ggrummer/PowerTimer/PowerTimerBOM_RevC.xlsx

Power Timer Assembly Parts Lists
Top Level Parts List
Description |  | Qty | Manufacturer | Part Number | Distributer
Power Block, 4 Outlet |  | 1 | Commercial Electric | 1007 546 208 | Home Depot
Screw, 4-40, 5/8" Long |  | 2 |  | 91772A112 | McMaster-Carr
Heat-Set Inserts for Plastic, Stainless Steel, 4-40 |  | 2 |  | 94459A426 | McMaster-Carr
Spacer Top |  | 1 | 3D Printed | Spacer Top2.stl
Spacer Bottom |  | 1 | 3D Printed | Spacer Bot.stl
Push Button Holder |  | 2 | 3D Printed | PushButHold.stl
Power Timer PCB Rev C |  | 1 | OSH Park or your choice | PowerTimerDesign.kicad_pcb
PCB Parts List |  |  |  |  | Rev C
Description | Reference | Qty | Manufacturer | Part Number | Distributer
Cap 270uF, 25V, Alum, Radial | C1,C6,C9,C12 | 4 | PANASONIC ELECTRONIC | EEU-FK1E271 | Digi-Key
Cap 0.1uF, 50V X7R, Radial | C2,C4,C7,C10,C13,C14,C15,C16 | 8 | Kemet | C326C104K5R5TA7301 | Digi-Key
Cap 0.01uF, 50V X7R, Radial | C3,C5,C8,C11 | 4 | Kemet | C316C103K5R5TA7301 | Digi-Key
Diode, Schottky, Axial, 1A, 20V | D1,D2,D3,D4 | 4 | MCC | 1N5817-TP | Digi-Key
Diode, Axial, 2A, 400V | D5 | 1 | Vishay Semiconductor | 1N5060TR | Digi-Key
AC/DC Converter 12V 3W | PS1 | 1 | RECOM POWER | RAC03-12SK | Digi-Key
Res, 1M, 1%, 1/4W | R1 | 1 | YAGEO | MFR-25FBF52-1M | Digi-Key
Res, 4.7K, 5%, 1/4W | R2,R5,R8,R11 | 4 | Stackpole | CF14JT4K70 | Digi-Key
Res, 680, 5%, 1/4W | R3,R4,R7,R10 | 4 | Stackpole | CF14JT680R | Digi-Key
Res, 2M, 1%, 1/4W | R6 | 1 | YAGEO | MFR-25FBF52-2M | Digi-Key
Res, 12.1M, 1%, 1/4W | R9 | 1 | KOA SPEER ELECTRONICS | RK1/4DCT52R1215F | Digi-Key
Relay, SPST 20A 12V | RL1 | 1 | AMERICAN ZETTLER | AZ762FV-1AE-12DF | Digi-Key
Switch, Push Button, Illumined | SW1,SW2,SW3,SW4 | 4 | SCHURTER | 0041.9146.3317 | Digi-Key
Timer, Dual, DIP14 | U1,U2 | 2 | TEXAS INSTRUMENTS | NE556N | Digi-Key
NAND Gate, 4-Input, Dual, DIP14 | U3,U4 | 2 | TEXAS INSTRUMENTS | CD4082BE | Digi-Key
