ggrummer/PowerTimer/PushButHold.stl

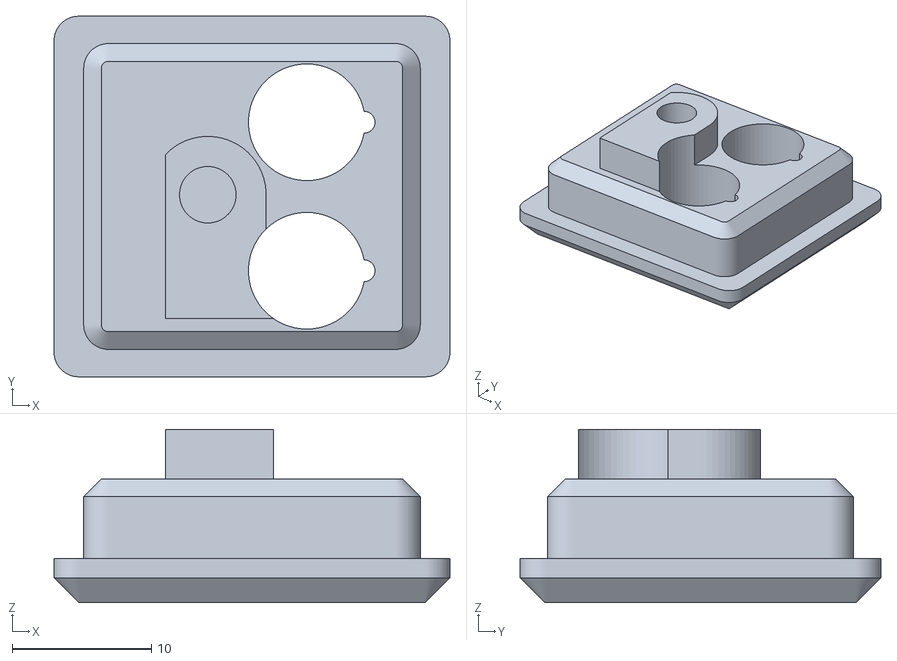
[picture p9: CAD file, 2026-03-17]
PushButHold.stl
28.4 x 25.9 x 12.4
