ggrummer/PowerTimer/Spacer Top2.stl

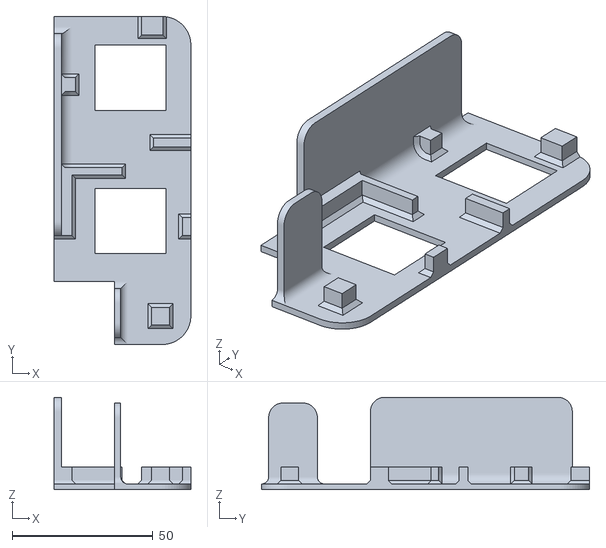
[picture p10: CAD file, 2026-03-17]
Spacer Top2.stl
48.5 x 116.3 x 32.8
