ggrummer/PowerTimer/Spacer Bot.stl

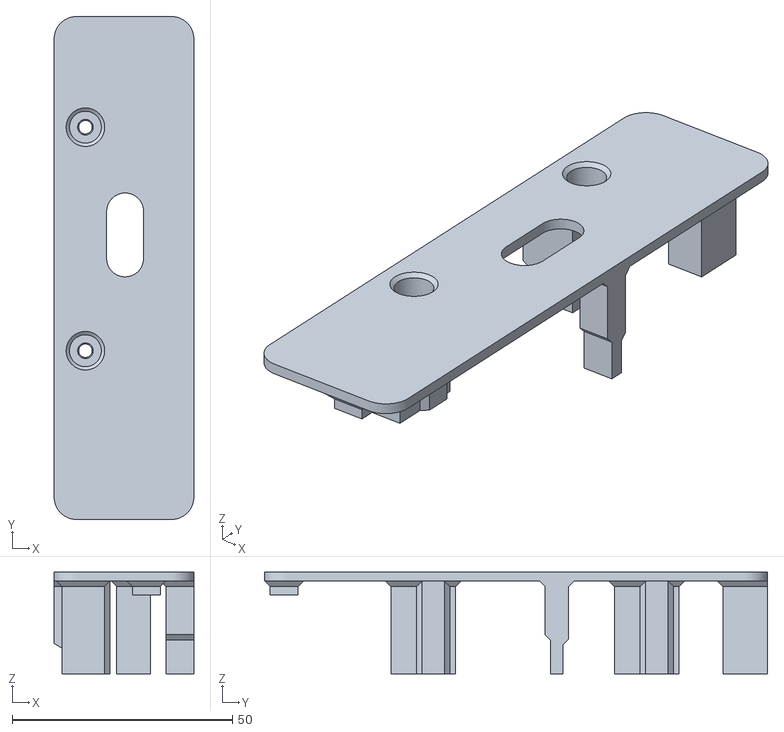
[picture p11: CAD file, 2026-03-17]
Spacer Bot.stl
31.8 x 114.3 x 23.2
