ggrummer/PowerTimer/PushButHold Drawing.pdf

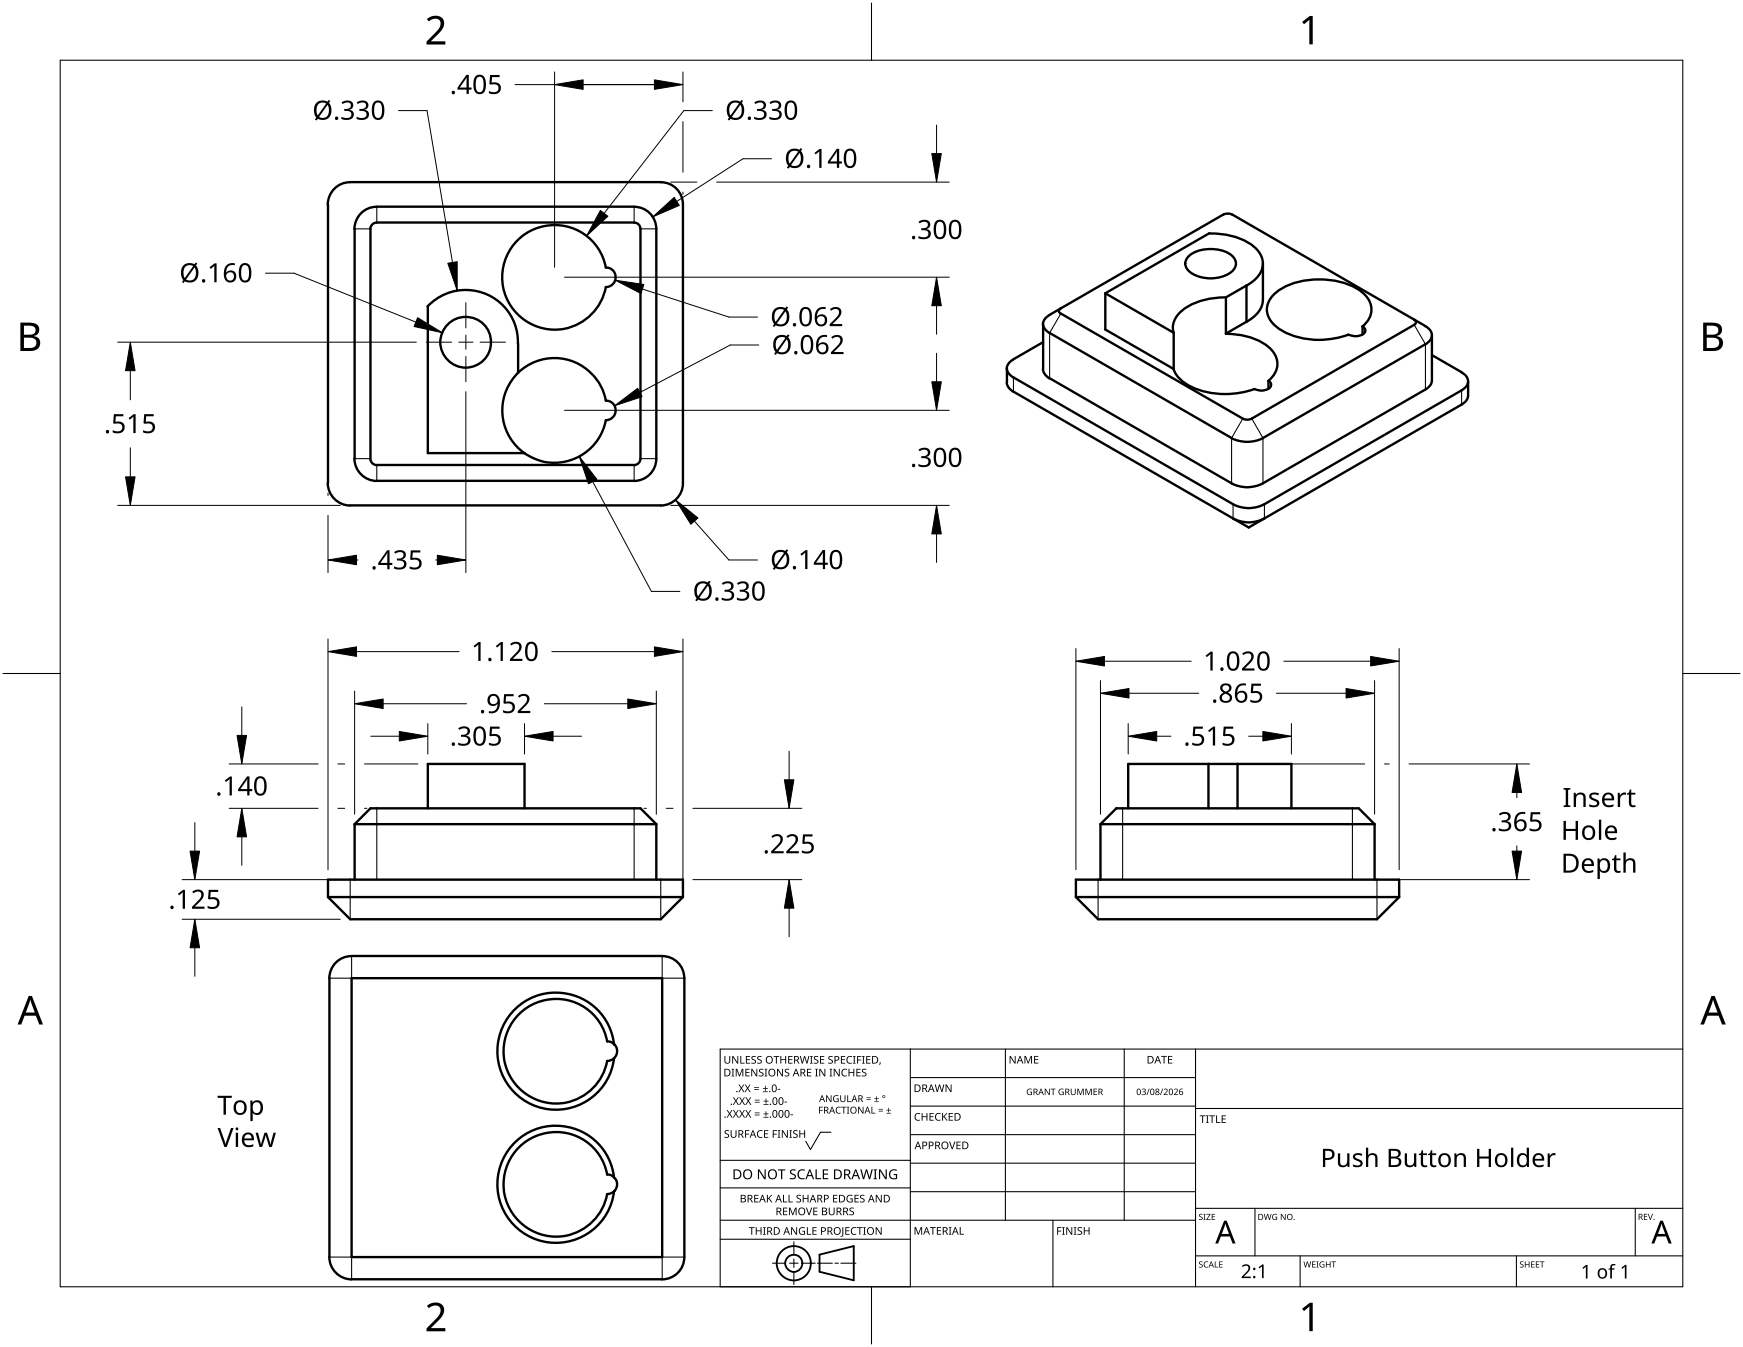
[picture p15: page 1]
