ggrummer/PowerTimer/Spacer Bot Drawing.pdf

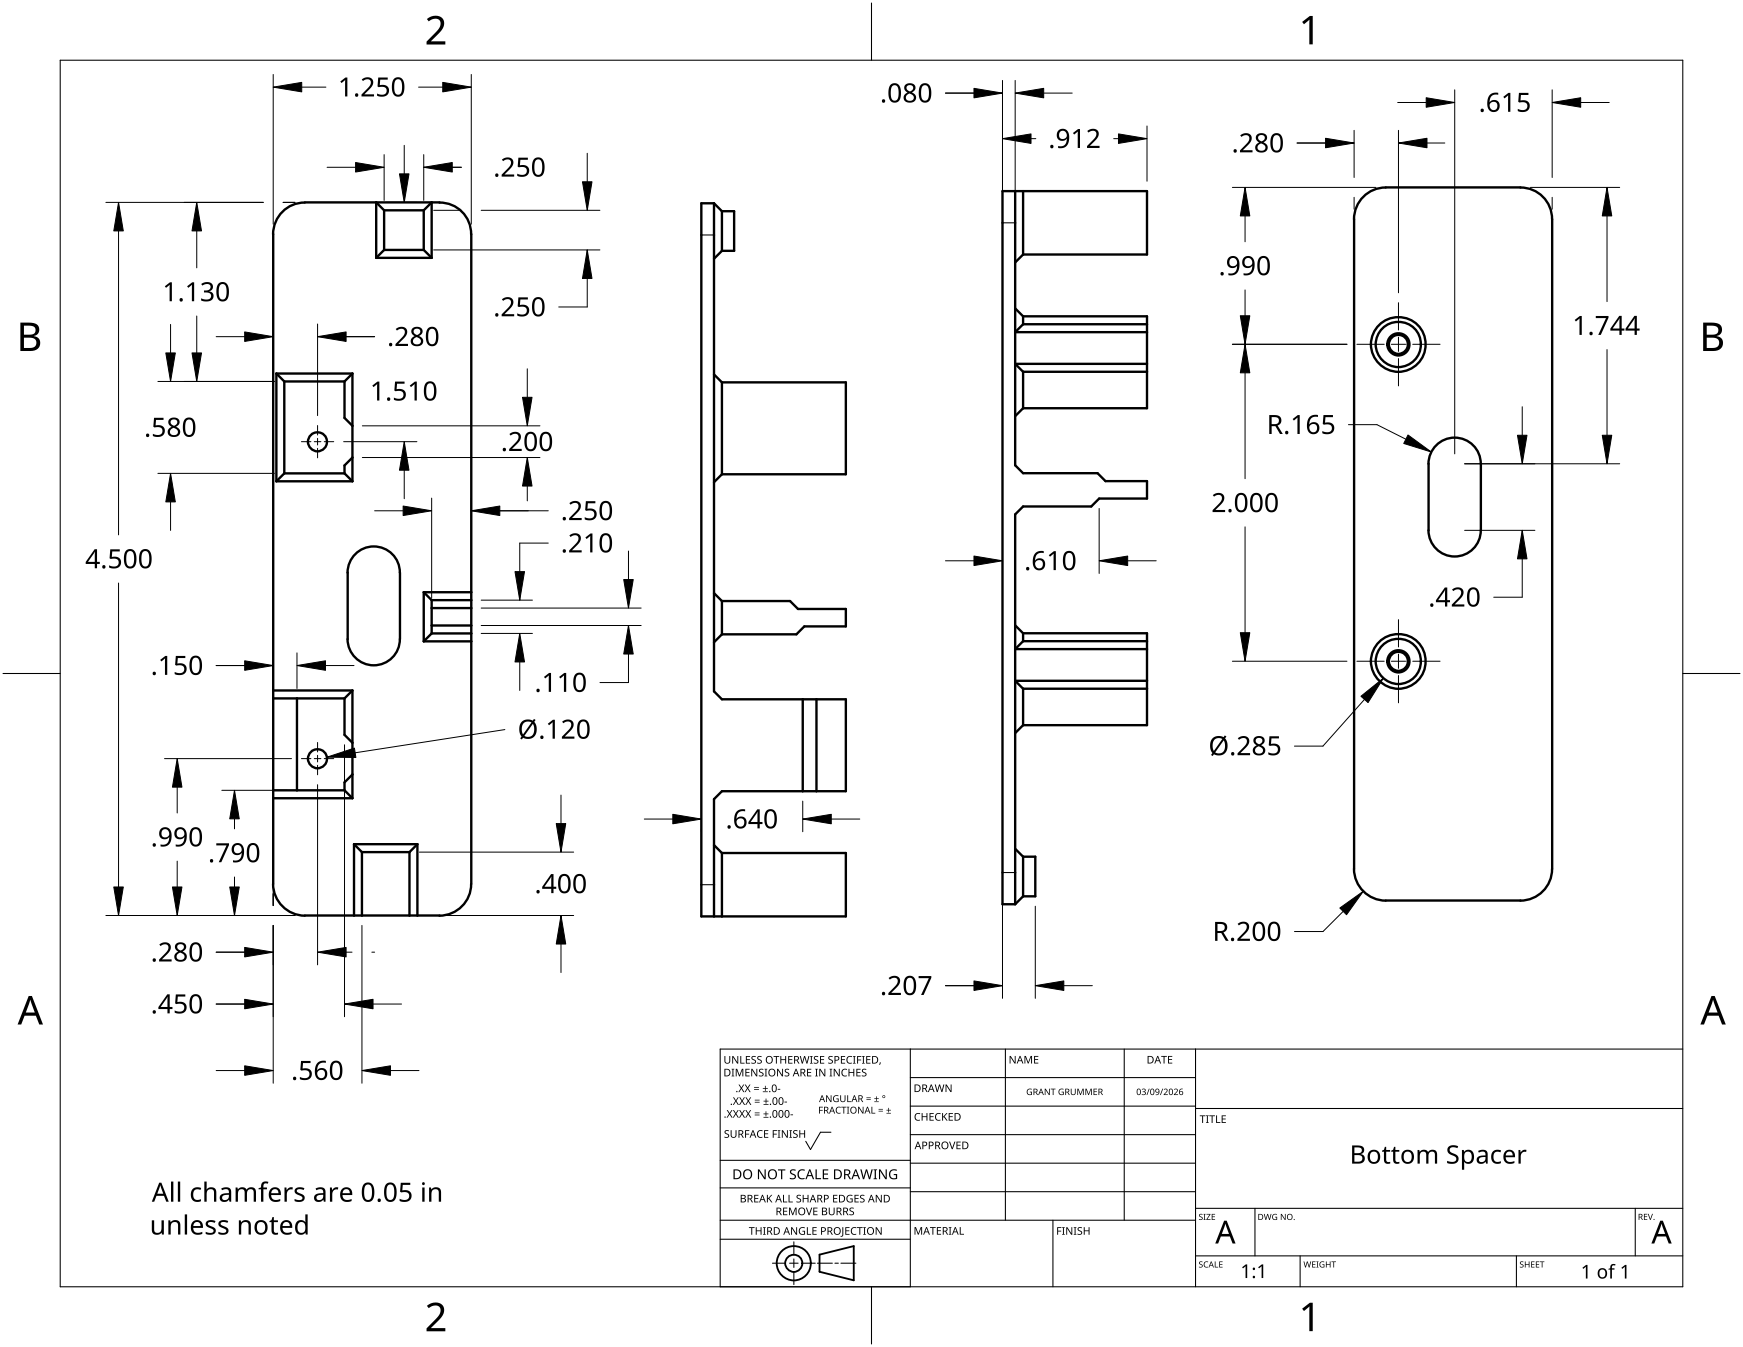
[picture p16: page 1]
