ggrummer/PowerTimer/Spacer Top2 Drawing.pdf

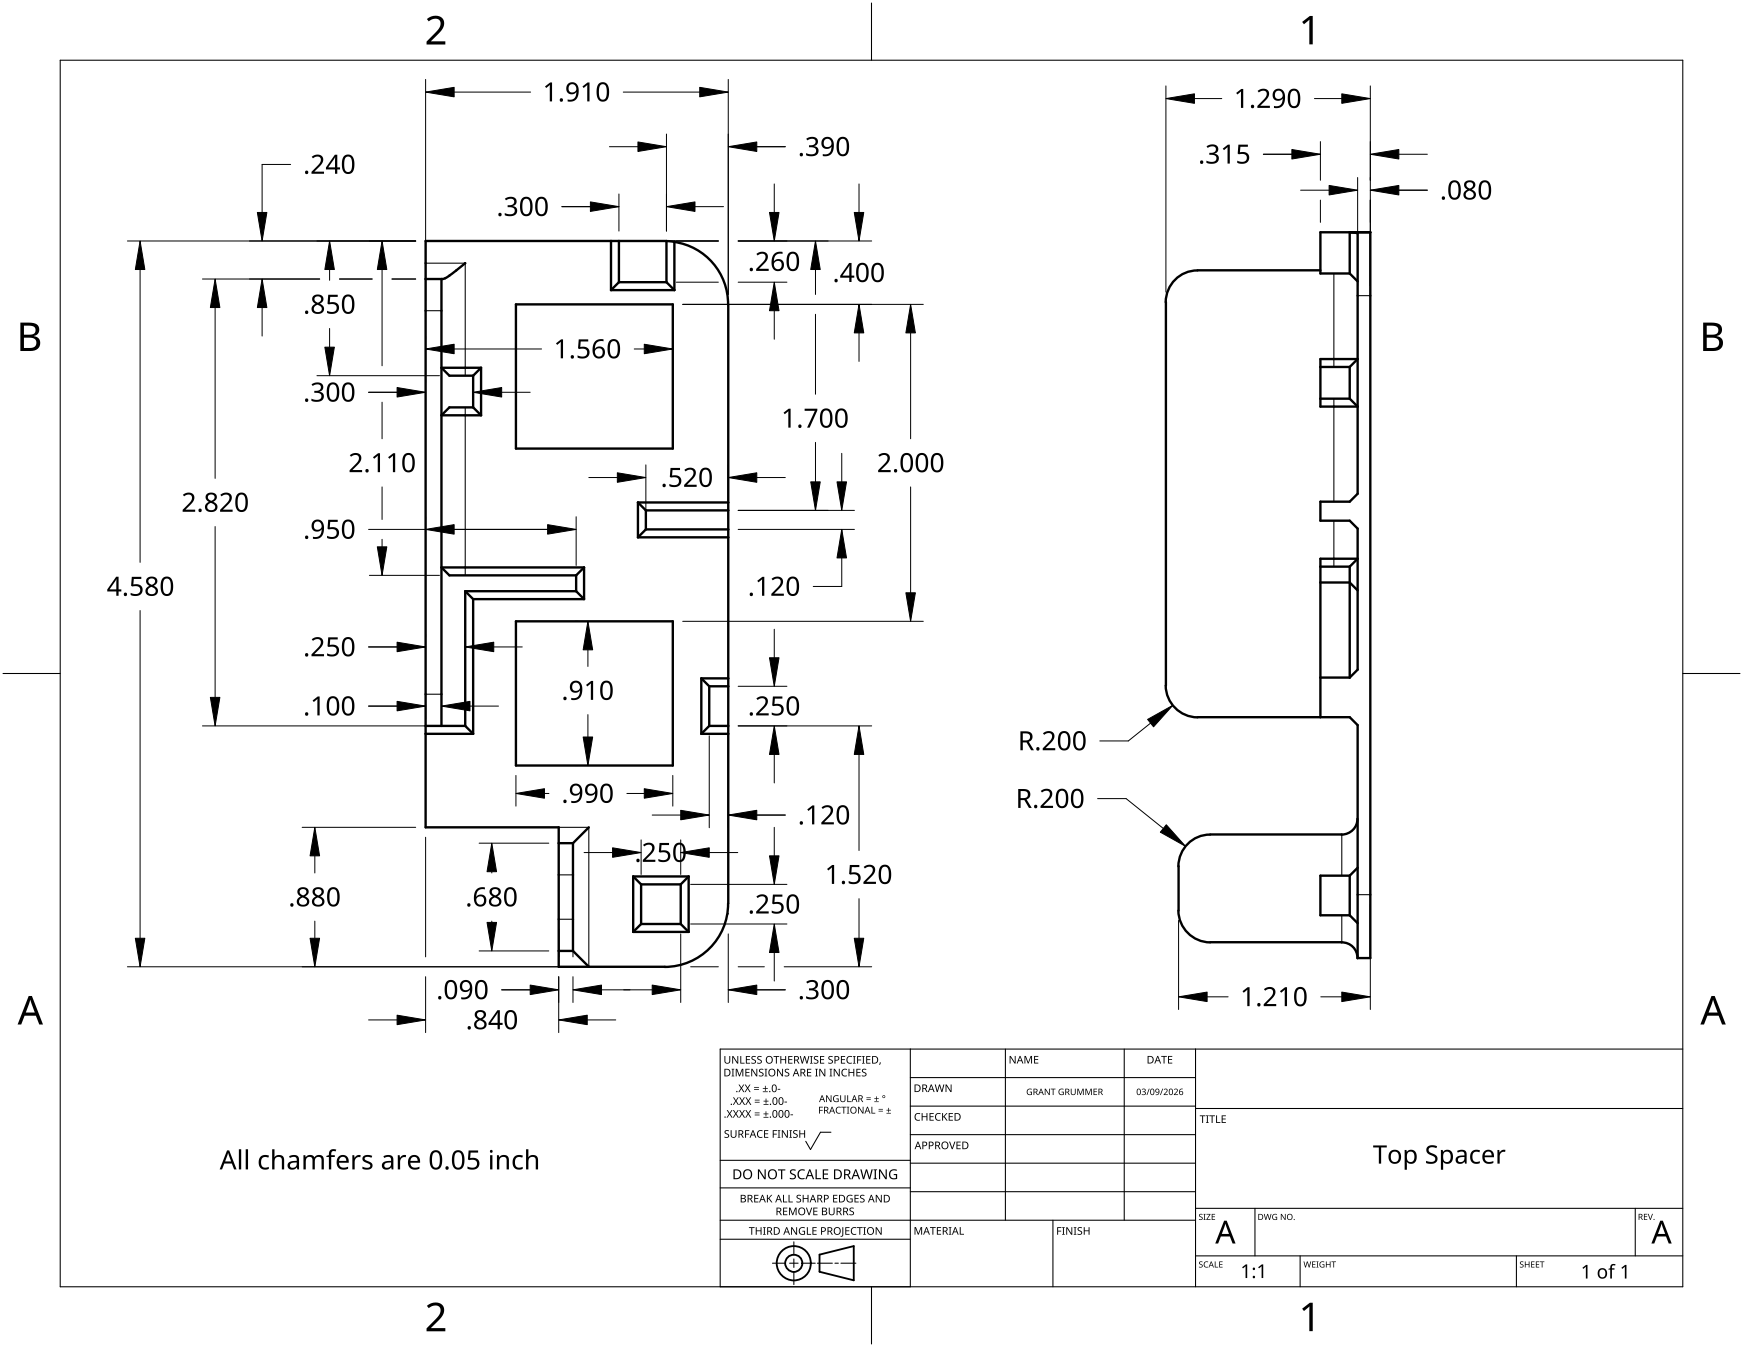
[picture p17: page 1]
