ggrummer/PowerTimer/PowerTimerDesign.kicad_pcb

## KiCad design PowerTimerDesign.kicad_pcb (2026-03-26)

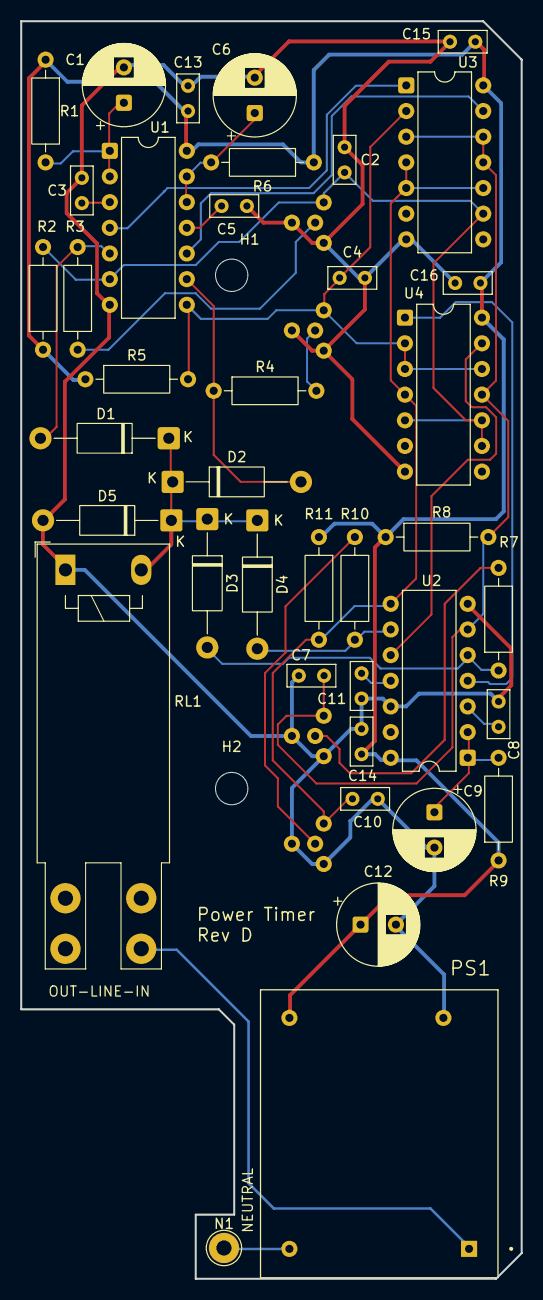
[picture p18: board PowerTimerDesign.kicad_pcb from above]

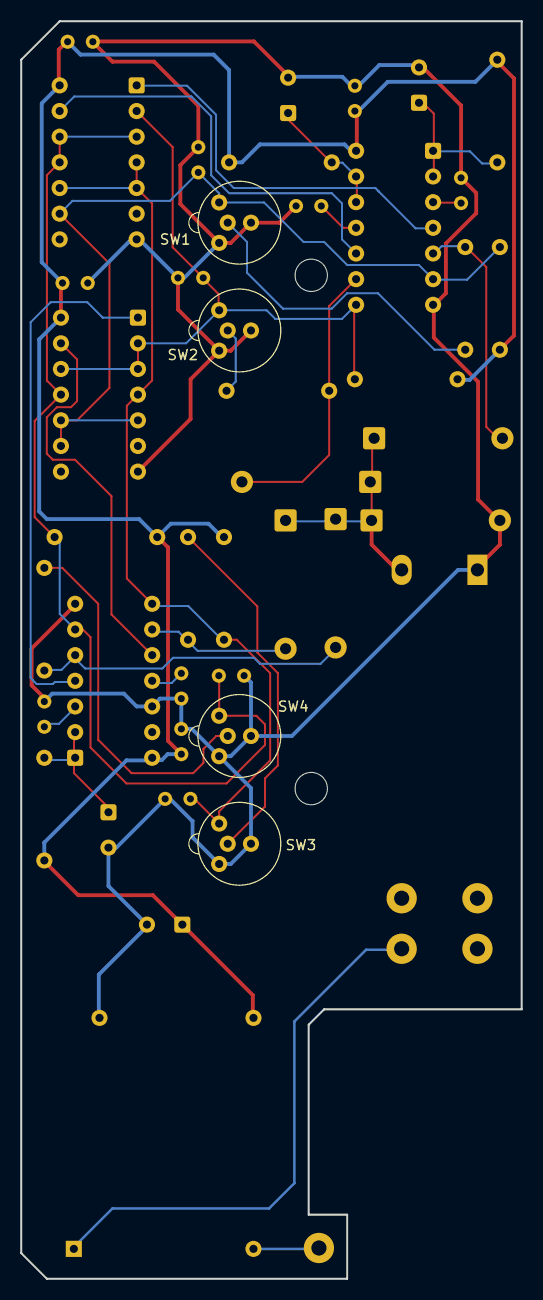
[picture p19: board PowerTimerDesign.kicad_pcb from below]

Board: 2 copper layers, 49.5 x 124.5 mm, 45 parts (4 on the bottom side), 28 nets.

Parts:
C1, C6, C9, C12: 270uF, 25V; CP_Radial_D8.0mm_P3.50mm
C2, C4, C7, C10, C13, C14, C15, C16: 0.1uF; C_Rect_L4.6mm_W2.0mm_P2.50mm_MKS02_FKP02
C3, C5, C8, C11: 0.01uF; C_Rect_L4.6mm_W2.0mm_P2.50mm_MKS02_FKP02
D1, D2, D3, D4: 1N5817; D_DO-41_SOD81_P12.70mm_Horizontal
D5: 1N5060; D_DO-41_SOD81_P12.70mm_Horizontal
H1: MountingHole; MountingHole_3.2mm_M3_DIN965
H2: MountingHole; MountingHole_3.2mm_M3
N1: TestPoint; TestPoint_THTPad_D3.0mm_Drill1.5mm
PS1: RAC03-12SK; CONV_RAC03-12SK
R1: 1M; R_Axial_DIN0207_L6.3mm_D2.5mm_P10.16mm_Horizontal
R2, R5, R8, R11: 4.7K; R_Axial_DIN0207_L6.3mm_D2.5mm_P10.16mm_Horizontal
R3, R4, R7, R10: 680; R_Axial_DIN0207_L6.3mm_D2.5mm_P10.16mm_Horizontal
R6: 2M; R_Axial_DIN0207_L6.3mm_D2.5mm_P10.16mm_Horizontal
R9: 12.1M; R_Axial_DIN0207_L6.3mm_D2.5mm_P10.16mm_Horizontal
RL1: AZ762FV-1AE-12DF; Relay_SPST_Zettler_AZ762F
SW1, SW2, SW3, SW4: 0041_9146_3317; Schurter_SPST_LDT
U1, U2: NE556; DIP-14_W7.62mm
U3, U4: 4082; DIP-14_W7.62mm

Connections:
+12V: C12.1, C13.1, C14.1, C15.1, C16.1, PS1.3 (+VOUT), R1.1, R2.1, R5.1, R6.1, R8.1, R9.1, R11.1, U1.14 (VCC), U2.14 (VCC), U3.14 (Vdd), U4.14 (Vdd)
/Power/DRV5: D1.2 (A), R3.1, U1.5 (Q)
/Power/DRV10: D2.2 (A), R4.1, U1.9 (Q)
/Power/DRV60: D3.2 (A), R7.1, U2.5 (Q)
/Power/DRVON: D4.2 (A), R10.1, U2.9 (Q)
/Power/LINEIN: PS1.1 (VAC_IN(L)), RL1.4
/Timers/LED5: R3.2, SW1.6 (A)
/Timers/LED10: R4.2, SW2.6 (A)
/Timers/LED60: R7.2, SW4.6 (A)
/Timers/LEDON: R10.2, SW3.6 (A)
/Timers/RST5: U1.4 (R), U3.1
/Timers/RST10: U1.10 (R), U3.13
/Timers/RST60: U2.4 (R), U4.1
/Timers/RSTON: U2.10 (R), U4.13
/Timers/SET5: C2.1, R2.2, SW1.2, U1.6 (TR), U3.9, U4.5, U4.9, U4.10
/Timers/SET10: C4.1, R5.2, SW2.2, U1.8 (TR), U3.2, U4.2, U4.3, U4.12
/Timers/SET60: C7.1, R8.2, SW4.2, U2.6 (TR), U3.3, U3.11, U3.12, U4.11
/Timers/SETON: C10.1, R11.2, SW3.2, U2.8 (TR), U3.4, U3.5, U3.10, U4.4
/Timers/TIME5: C1.1, R1.2, U1.1 (DIS), U1.2 (THR)
/Timers/TIME10: C6.1, R6.2, U1.12 (THR), U1.13 (DIS)
/Timers/TIME60: C9.1, R9.2, U2.1 (DIS), U2.2 (THR)
GND: C1.2, C2.2, C3.2, C4.2, C5.2, C6.2, C7.2, C8.2, C9.2, C10.2, C11.2, C12.2, C13.2, C14.2, C15.2, C16.2, D5.2 (A), PS1.2 (-VOUT), RL1.1, SW1.1, SW1.5 (K), SW2.1, SW2.5 (K), SW3.1, SW3.5 (K), SW4.1, SW4.5 (K), U1.7 (GND), U2.7 (GND), U2.12 (THR), U3.7 (Vss), U4.7 (Vss)
unnamed: D1.1 (K), D2.1 (K), D3.1 (K), D4.1 (K), D5.1 (K), RL1.6
unnamed: N1.1, PS1.4 (VAC_IN(N))
unnamed: C3.1, U1.3 (CV)
unnamed: C5.1, U1.11 (CV)
unnamed: C8.1, U2.3 (CV)
unnamed: C11.1, U2.11 (CV)
