ggrummer/PowerTimer/(commit log)

2026-03-17 Initial entry of project files
    [PowerTimerBOM_RevC.xlsx, PowerTimerDesign.kicad_pcb, PushButHold.stl, Spacer Bot.stl, Spacer Top2.stl]
2026-03-23 Added schematic for PCB
    Added the schematic for the Power Timer PCB.
2026-03-26 Replaced Rev C design with Rev D
    Swapped R10 & R11 Ref Des (they were on the wrong resistor).
    Rewired SW3 and SW4 so their functions would be swapped (so on Rev D, the order on the unit is now: Stay On, 1 Hour, 10 Minutes & 5 Minutes)
    [PowerTimerDesign.kicad_pcb]
